baileyji/M2FS-FLS-ADC_A/Project Outputs for FLS ADC_A  Aug_1_2012/DiffReport/FLS ADC_A.html

Altium

# Differences Report for Project FLS ADC_A Aug_14_2012.PrjPcb and FLS ADC_A.PcbDoc

Date | : | 11/23/2012
Time | : | 11:20:00 PM
Filename | : | Z:\Dropbox\M2FS-Dropbox\circuit boards\M2FS FLS ADC_A\Project Outputs for FLS ADC_A Aug_1_2012\DiffReport\FLS ADC_A.html

## Extra Component Classes

Schematic Object | PCB Object
[MAX9153]

Back to top

## Extra Net Classes

Schematic Object | PCB Object
| [Differential]
| [Match Lengths 1]
| [Match Lengths 2]
| [Match Lengths]

Back to top

## Component Classes With Extra Members

Schematic Object | PCB Object
[R10]

Back to top

## Extra Room Definitions

Schematic Object | PCB Object
[Room FLS ADC_ A (Scope=InComponentClass('FLS ADC_ A')) TopLayer]
[Room MAX9153 (Scope=InComponentClass('MAX9153')) TopLayer]
[Room MAX9153 (Scope=InComponentClass('MAX9153')) TopLayer]
[Room PP1 (Scope=InComponentClass('PP1')) TopLayer]

Back to top

## Different Designators

Schematic Object | PCB Object
[R10] | [R10 - Bias]

Back to top

## Different Footprints

Schematic Object | PCB Object
RESC0805(2012)_N [R11] | RESC0805(2012)_L [R11]

Back to top
