baileyji/M2FS-FLS-ADC_A/remove mystery TP2 from design.XLS

Change Order Report For Project |  |  | FLS Data Formatter 8_14_2012.PrjPCB And FLS Data Formatter 8_14_2012.PrjPCB
Action | Object |  |  | Change Document | Status
Remove Component Class Members
 | Remove | TP2 from M2FS FLS Data Formatter 8_14_2012 | In | M2FS FLS Data Formatter 8_14_2012.PcbDoc
Remove Components
 | Remove | TP2 | From | M2FS FLS Data Formatter 8_14_2012.PcbDoc
Wednesday 31-Oct-31/2012 11:48:32 AM |  |  |  |  |  | Page 1 of 1
