baileyji/M2FS-FLS-ADC_A/RTM 11.22.12/FLS ADC BOM.xlsx

ITEM | Quantity/bd | REFERENCE DESIG. | VALUE | FOOTPRINT | Description | Mnfr or vendor description/ specs | Manfr. | Manf part # given by Vendor | Distributor | Distributor P/N | ASSEMBLY / PROCUREMENT REMARKS | Notes | Customer Response
1 | 14 | C1, C3, C4, C5, C6, C7, C8, C9 | 0.1uF | 0805 | Non-polarized Capacitor (Surface Mount) | CAP CER 0.1UF 25V Y5V 0805 | Murata Electronics North America | GRM216F51E104ZA01D | Digi-Key | 490-1726-2-ND
 |  | C10, C11, C12, C21, C26, C27
2 | 5 | C2, C13, C14, C17, C20 | 10uF | 1206 | Polarized Capacitor (Surface Mount) | CAP TANT 10UF 16V 10% 1206 | Vishay Sprague | TR3A106K016C1700 (http://www.digikey.com/product-detail/en/TR3A106K016C1700/718-1301-1-ND/1663023) | Digi-Key | 718-1301-1-ND
3 | 4 | C15, C18, C22, C24 | 47uF | 1210 | Polarized Capacitor (Surface Mount) | CAP TANT 47UF 10V 10% 1210 | AVX Corporation | TPSB476K010R0250 (http://www.digikey.com/product-detail/en/TPSB476K010R0250/478-3085-1-ND/809598) | Digi-Key | 478-3085-1-ND (http://www.digikey.com/product-detail/en/TPSB476K010R0250/478-3085-1-ND/809598)
4 | 2 | C16, C19 | 100uF | 1210 | Polarized Capacitor (Surface Mount) | CAP TANT 100UF 10V 10% 1206 | Nichicon | F951A107KTAAQ2 (http://www.digikey.com/product-detail/en/F951A107KTAAQ2/493-4253-1-ND/2529980) | Digi-Key | 493-4253-1-ND (http://www.digikey.com/product-detail/en/F951A107KTAAQ2/493-4253-1-ND/2529980)
5 | 2 | C23, C25 | 220uF | 1210 | Polarized Capacitor (Surface Mount) | CAP TANT 220UF 10V 20% 1210 | AVX Corporation (http://digikey.com/Suppliers/us/AVX.page?lang=en) | TLNT227M010R1300 | Digi-Key | 478-6612-1-ND
6 | 3 | R1, R2, R3 | 100 | 603 | Thin Film ±25ppm/°C Resistor | RES 100 OHM 1/10W .1% 0603 SMD | Panasonic Electronic Components | ERA-3YEB101V (http://www.digikey.com/product-detail/en/ERA-3YEB101V/P100YCT-ND/282787) | Digi-Key | P100YCT-ND (http://www.digikey.com/product-detail/en/ERA-3YEB101V/P100YCT-ND/282787)
7 | 2 | R4, R10 | 10K | V1240W | V1240W | TRIMMER 10K OHM 0.25W TH | Vishay Foil Resistors (Division of Vishay Precision Group) | Y405310K0000J0L | Digi-Key | 804-1003-ND
8 | 2 | R5, R6 | 348K | 603 | Thick Film ±100ppm/°C Resistor | RES 348K OHM 1/10W 1% 0603 SMD | Panasonic Electronic Components | ERJ-3EKF3483V | Digi-Key | P348KHDKR-ND
9 | 2 | R7, R8 | 523 | 603 | Thin Film ±25ppm/°C Resistor | RES 523 OHM 1/10W .1% 0603 SMD | Susumu | RG1608P-5230-B-T5 | Digi-Key | RG16P523BDKR-ND
10 | 1 | R9 | 4K7 | 1206 | Thin Film ±25ppm/°C Resistor | RES 4.7K OHM 1/4W .1% 1206 | Susumu | RG3216P-4701-B-T1 (http://www.digikey.com/product-detail/en/RG3216P-4701-B-T1/RG32P4.7KBCT-ND/2078718) | Digi-Key | RG32P4.7KBCT-ND (http://www.digikey.com/product-detail/en/RG3216P-4701-B-T1/RG32P4.7KBCT-ND/2078718)
11 | 1 | R11 | 0 | 805 | Jumper | RES 0.0 OHM 1/8W 0805 SMD | Panasonic Electronic Components | ERJ-6GEY0R00V (http://www.digikey.com/product-detail/en/ERJ-6GEY0R00V/P0.0ACT-ND/82955) | Digi-Key | P0.0ACT-ND (http://www.digikey.com/product-detail/en/ERJ-6GEY0R00V/P0.0ACT-ND/82955)
12 | 5 | J1, J2, J3, J4, J12 |  | SIP4 | Male Pin Header, Unshrouded, Gold | CONN HEADER 4POS .100 VERT GOLD | Molex Connector Corporation | 22112042 | Digikey | WM2702-ND
13 | 1 | J5 |  | RJ11 - Vertical | RJ11 - Vertical | CONN MOD JACK 6-6 VERT PCB 50AU | TE Connectivity | 5520258-3 | Digikey | A31411-ND
14 | 2 | J6, J7 |  | RJ45 Vertical Single | RJ45 Vertical Single | CONN JACK RJ45 8-8 VERT T/H SLD | Amphenol Commercial Products | RJHSE-3380 | Digikey | RJHSE-3380-ND
15 | 4 | J8, J9, J10, J11 |  | Molex 471554001 | SATA Connector | CONN SATA HDR 7POS PCB VERT | Molex Inc | 471554001 | Digikey | WM4059-ND
16 | 1 | U1 |  | 14-TVSOP | Quadruple 2-Input Positive-AND Gate | SN74AHC08DGVR | Texas Instruments | SN74AHC08DBR | Digikey | 296-4522-1-ND
17 | 1 | U2 |  | BGA80P8X8-64B | IC ADC 8BIT QUAD 65MSPS 64CSPBGA | AD9289 | Analog Devices Inc | AD9289BBC | Digikey | AD9289BBC-ND
18 | 2 | U3, U4 |  | MAX9153EUI | LVDS Interface IC 800Mbps 10-Port LVDS Repeater | MAX9153EUI+ | Maxim Integrated Products | MAX9153EUI+ | Mouser | 700-MAX9153EUI+
19 | 2 | U5, U6 |  | QFN-N39 | IC BUCK SYNC ADJ 4A 39B1QFN | TPS84410 | Texas Instruments | TPS84410RKGT | Digikey | 296-29689-6-ND
20 | 1 | U7 |  | SOT353 | Inverter, Buffer | IC INVERTER SGL HS CMOS SOT353 | ON Semiconductor | MC74VHC1G04DFT2GOSDKR-ND | Digikey | MC74VHC1G04DFT2G
 | 43 | <-- Number of components
