baileyji/M2FS-FLS-ADC_A/Project Outputs for FLS ADC_A  Aug_1_2012/BOM/Bill of Materials-FLS ADC_A Aug_14_2012.xls

Sheet: BOM Report
Bill of Materials |  |  | <Parameter Title not found>
Source Data From: |  | FLS ADC_A Aug_14_2012.PrjPcb
Project: |  | FLS ADC_A Aug_14_2012.PrjPcb
Variant: |  | None
Creation Date: | 11/23/2012 | 11:19:53 PM
Print Date: | 41236 | 41236.97217
Footprint | Comment | LibRef | Designator | Description | Quantity
SIP3 | SW-SPDT | TP3 | 1's |  | 1
0805 slim | 0.1uF | Cap | C1, C3, C4, C5, C6, C7, C8, C9, C10, C11, C12, C21, C26, C27 | Capacitor | 14
1206 | 10uF | Cap Pol3 | C2, C13, C14, C17, C20 | Polarized Capacitor (Surface Mount) | 5
TC3528-1411 | 47uF | Cap Pol3 | C15, C18, C22, C24 | Polarized Capacitor (Surface Mount) | 4
TC3528-1411 | 100uF | Cap Pol3 | C16, C19 | Polarized Capacitor (Surface Mount) | 2
TC3528-1411 | 220uF | Cap Pol3 | C23, C25 | Polarized Capacitor (Surface Mount) | 2
SIP4 | CON4 | CON4 | J1, J2, J3, J4 |  | 4
RJ11 - Vertical | RJ-11 | RJ-11 | J5 | RJ-11 6-PIN CONNECTOR | 1
RJ45 Vertical Single | RJ45 - JACK | RJ45 - JACK | J6, J7 |  | 2
Molex 471554001 | SATA PLUG 7POS | SATA PLUG 7POS | J8, J9, J10, J11 |  | 4
SIP5 | POWER | CON5 | J12 |  | 1
STARFLAKE | starflake | starflake | logo1, logo2 |  | 2
J1-0603 | 100 | Res1 | R1, R2, R3 | Resistor | 3
V1240W | 10K | POT1 | R4, R10 |  | 2
J1-0603 | 348K | Res3 | R5, R6 | Resistor | 2
J1-0603 | 523 | Res3 | R7, R8 | Resistor | 2
1206 | 4K7 | Res1 | R9 | Resistor | 1
RESC0805(2012)_N | Jumper 0805(2012) | CMP-1013-00001-1 | R11 | Jumper 0805 (2012 Metric) | 1
TP-107 | TP-107 | TP-107 | Test Point 1, Test Point 2, Test Point 3, Test Point 4, Test Point 5, Test Point 6 |  | 6
DGV014 | SN74AHC08BQ | SN74AHC08DBLE | U1 | Quadruple 2-Input Positive-AND Gate | 1
BGA80P8X8-64B | AD9289 | AD9289 | U2 |  | 1
MAX9153EUI | MAX9153 | MAX9153 | U3, U4 |  | 2
QFN-N39 | TPS84410 | TPS84410 | U5, U6 |  | 2
419A-01_N | MC74VHC1G04DFT2G | MC74VHC1G04DFT1 | U7 | Inverter | 1
 |  |  |  |  | 66
Approved |  | Notes

Sheet: Project Information
Project Full Path | Z:\Dropbox\M2FS-Dropbox\circuit boards\M2FS FLS ADC_A\FLS ADC_A Aug_14_2012.PrjPcb
Project Filename | FLS ADC_A Aug_14_2012.PrjPcb
Variant Name | None
Data-Source Filename | FLS ADC_A Aug_14_2012.PrjPcb
Data-Source Full Path | Z:\Dropbox\M2FS-Dropbox\circuit boards\M2FS FLS ADC_A\FLS ADC_A Aug_14_2012.PrjPcb
Title | <Parameter Title not found>
Total Quantity | 66
Report Time | 11:19:53 PM
Report Date | 11/23/2012
Report Date & Tine | 11/23/2012 11:19:53 PM
Output Name | Bill of Materials
Output Type | BOM_PartType
Output Generator Name | BOM
Output Generator Description | Bill of Materials
