baileyji/M2FS-FLS-ADC_A/Project Outputs for FLS ADC_A  Aug_1_2012/ExportSTEP/FLS ADC_A.step

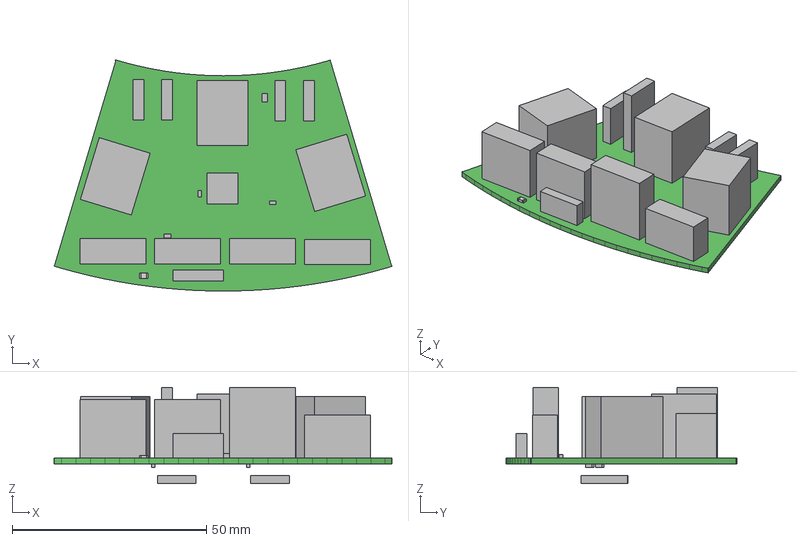
[picture p1: CAD file, 2013-03-20]
Project Outputs for FLS ADC_A Aug_1_2012/ExportSTEP/FLS ADC_A.step
86.9 x 59.4 x 24.7 mm
Board
R10_-_Bias
Extruded x 26
R4
