baileyji/M2FS-FLS-ADC_A/(list of files, drawings)

Other design files:
FLS ADC_ A.SchDoc
FLS ADC_A Aug_14_2012.PrjPcb
FLS ADC_A POWER SUPPLY.SchDoc
FLS ADC_A.PcbDoc
FLS ADC_A.PcbLib
FLS ADC_A.SchLib
FLS Clock_A Distribution.SchDoc
FLS Start_A Distribution.SchDoc
