baileyji/M2FS-FLS-ADC_A/somehow U3-3&4 got swapped on PCB verified with datasheet and fixed.XLS

Change Order Report For Project |  |  | FLS ADC_A Aug_14_2012.PrjPcb And FLS ADC_A Aug_14_2012.PrjPcb
Action | Object |  |  | Change Document | Status
Remove Pins From Nets
 | Remove | U3-3 from SYS_CLK_ADC_A_N | In | FLS ADC_A.PcbDoc
 | Remove | U3-4 from SYS_CLK_ADC_A_P | In | FLS ADC_A.PcbDoc
Add Pins To Nets
 | Add | U3-3 to SYS_CLK_ADC_A_P | In | FLS ADC_A.PcbDoc
 | Add | U3-4 to SYS_CLK_ADC_A_N | In | FLS ADC_A.PcbDoc
Monday 22-Oct-22/2012 1:41:06 PM |  |  |  |  |  | Page 1 of 1
