baileyji/M2FS-FLS-ADC_A/bring bad footprint into schematic for later fix.XLS

Change Order Report For Project |  |  | FLS ADC_A Aug_14_2012.PrjPcb And FLS ADC_A Aug_14_2012.PrjPcb
Action | Object |  |  | Change Document | Status
Change Component Footprints
 | Modify | TSSOP28-Max -> TSSOP50P640-28N [U3] | In | FLS ADC_ A.SchDoc
 | Modify | TSSOP28-Max -> TSSOP50P640-28N [U4] | In | FLS ADC_ A.SchDoc
Wednesday 10-Oct-10/2012 9:54:56 AM |  |  |  |  |  | Page 1 of 1
