baileyji/M2FS-FLS-ADC_A/fix C1-1 agnd to gnd.XLS

Change Order Report For Project |  |  | FLS ADC_A Aug_14_2012.PrjPcb And FLS ADC_A Aug_14_2012.PrjPcb
Action | Object |  |  | Change Document | Status
Remove Pins From Nets
 | Remove | C1-1 from AGND | In | FLS ADC_A.PcbDoc
Add Pins To Nets
 | Add | C1-1 to GND | In | FLS ADC_A.PcbDoc
Wednesday 10-Oct-10/2012 9:39:48 AM |  |  |  |  |  | Page 1 of 1
