baileyji/M2FS-FLS-ADC_A/(commit log)

2012-10-14 Added correct MAX footprint and began routing. Fixed TI84410 footprints.
    [FLS ADC_A.PcbDoc, FLS ADC_A.PcbLib, FLS Clock_A Distribution.SchDoc, FLS Start_A Distribution.SchDoc]
2012-10-14 Revert "Added correct MAX footprint and began routing. Fixed TI84410 footprints."
    This reverts commit e554bff6d1cd263e8bfbc5fa3605721ac07e2840.
    [FLS ADC_A.PcbDoc, FLS ADC_A.PcbLib, FLS Clock_A Distribution.SchDoc, FLS Start_A Distribution.SchDoc]
2012-10-14 Revert "Revert "Added correct MAX footprint and began routing. Fixed TI84410 footprints.""
    This reverts commit 659392b27bc97fd20302d7b758c3abab3f25a1c6.
    [FLS ADC_A.PcbDoc, FLS ADC_A.PcbLib, FLS Clock_A Distribution.SchDoc, FLS Start_A Distribution.SchDoc]
2012-10-15 Working on routing for MAX chips ~75% complete.
    [FLS ADC_A Aug_14_2012.PrjPcb, FLS ADC_A.PcbDoc]
2012-10-21 Working on Routing. Split 5V0 3VCCA Plane.
    [FLS ADC_ A.SchDoc, FLS ADC_A Aug_14_2012.PrjPcb, FLS ADC_A.PcbDoc]
2012-10-22 Swapped some pins to ease routing. Started Tuning Lengths. Swapped pins on J6 (previously (as well) on J7) must change dataformatter to match! Need to double check pins on U3.
    [FLS ADC_ A.SchDoc, FLS ADC_A.PcbDoc, FLS ADC_A.SchLib, swap J6 pins 4&6.XLS, swap clock distribution pins.XLS]
2012-10-22 Design nearly complete. For initial review.
    There are a number of unrouted net violations on AGND 3VCCA & GND. I
    suspect this is a result of the gaps in the polygons after doing the
    serpentine routes.
    [FLS ADC_A.PcbDoc, FLS Clock_A Distribution.SchDoc, somehow U3-3&4 got swapped on PCB verified with datasheet and fixed.XLS]
2012-10-23 ADC ready for review. Two unnamed unrouted net errors remain. Is error an error?
    [FLS ADC_A.PcbDoc]
2012-10-24 ADC Review 1
    1. unrouted trace 1: Test Point 3VCCA is floating. It may be corrected
    by providing a multi-layer via through the pad so it hits Internal Plane
    2 (split plane 3VCCA).
    2. unrouted trace 2: Pin CCW at 2220, 200 is floating. It must be
    connected to 3VCCA.
    3. Add trace from the AGND via below the power connector to gnd pin 1 of
    the connector, for the single-point ground connection. Watch out for
    unintended effects when repouring copper.
    4. Internal plane 2 bottom left, change designation '3VCCA' to 5V0.
    Might as well move '3VCCA' to split plane around BGA.
    5. Re-enable Top Overlay before gerber file creation.
    6. Many overlay designations need to be moved out of the way of vias and
    p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
2012-10-24 Corrections from review 1. Design passes DRC.
    Note that I've used impeadance controlled widths for all the
    differential traces. This means I've input the stackup & dielectric
    constants from Bittele into Altium and told it to use its default
    microstrip and stripline trace width/impedance formulae.
    Finally I've created a rule for all the differential signals specifying
    impedance controlled widths with a preferred impedance of 50 Ohms. This
    gives nominal widths of:
    11.548 mils for outer layers
    12.968 mils for inner layers.
    I have not made ann adjustments for propogation delays within a
    dielectric. Do they need to (refrence outstanding questions in email)?
    [FLS ADC_A.PcbDoc, FLS ADC_A.PcbLib]
2012-10-25 Top and Bottom Overlay corrections
    1. J12 Power connector overlay swapped to top side
    2. Rectangular overlay of U4, sides brought down to match top line. This
    change is to U4 only, not the library.
    3. Test pad '3VCCD' designation moved to top of test pad.
    4. '3VCCA' text moved to top of test pad.
    [FLS ADC_A.PcbDoc]
2012-10-29 First generation of gerbers for Bittele
    Conflicts:
    FLS ADC_A.PcbDoc
    [Bill of Materials-FLS ADC_A Aug_14_2012.xls, FLS ADC BOM.xlsx, FLS ADC_A Aug_14_2012.PrjPcb, FLS ADC_A Aug_14_2012_BOM.csv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]
2012-10-29 Impedance updated for differential routes. Prep for RTM
    [Bill of Materials-FLS ADC_A Aug_14_2012.xls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]
2012-11-12 Added R11 between gnd & agnd. Swapped pinout on RJ45 connectors back.
    [Bill of Materials-FLS ADC_A Aug_14_2012.xls, FLS ADC BOM.xlsx, FLS ADC_ A.SchDoc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]
2012-11-12 RTM Candidate
    [Bill of Materials-FLS ADC_A Aug_14_2012.xls, FLS ADC BOM.xlsx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]
2012-11-12 RTM Candidate Cleanup
    [FLS ADC_A.GBL, FLS ADC_A.GBO, FLS ADC_A.GBP, FLS ADC_A.GBS, FLS ADC_A.GTL, FLS ADC_A.GTO, FLS ADC_A.GTP, FLS ADC_A.GTS]
2013-03-20 Changes in preparation for final revision.
    Change power supplies to LDOs, ground sense and Vref caps, add
    termination resistor to sys_clock line to ADC.
    [Add missing termination resistor and ground ADC sense line and Vref per fig 32 of datasheet.XLS, Bill of Materials-FLS ADC_A Aug_14_2012.xls, FLS ADC BOM.xlsx, FLS ADC_ A.SchDoc, FLS ADC_A Aug_14_2012.PrjPcb, FLS ADC_A POWER SUPPLY.SchDoc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]
